apsteven/MSE-Control-Boards/Micro_RC_Receiver/Micro_RC_Receiver-master/2.jpg

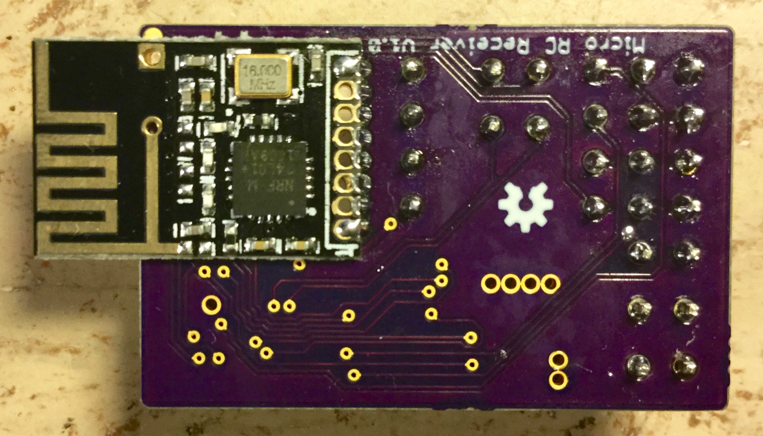
Micro_RC_Receiver/Micro_RC_Receiver-master/2.jpg
