apsteven/MSE-Control-Boards/Micro_RC_Receiver/Micro_RC_Receiver-master/1.jpg

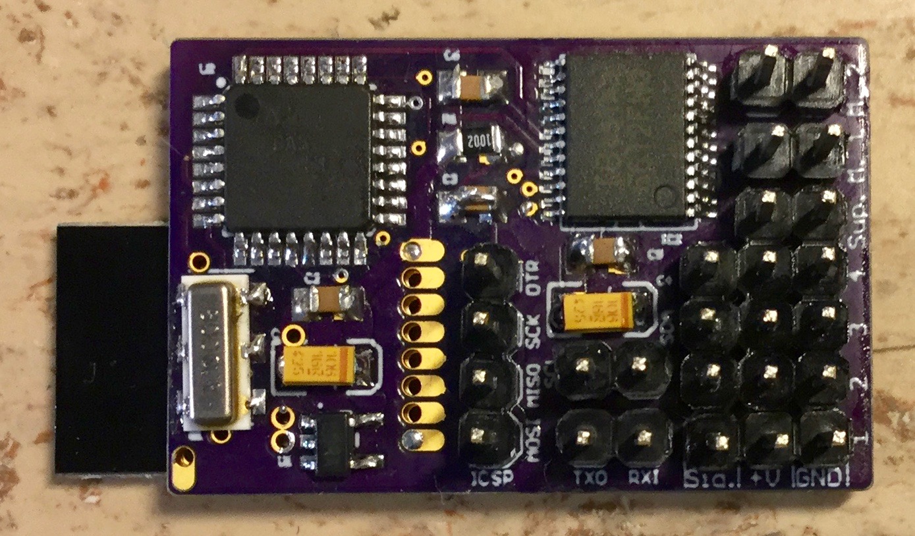
Micro_RC_Receiver/Micro_RC_Receiver-master/1.jpg
