apsteven/MSE-Control-Boards/Micro_RC_Receiver/Micro_RC_Receiver-master/3.jpg

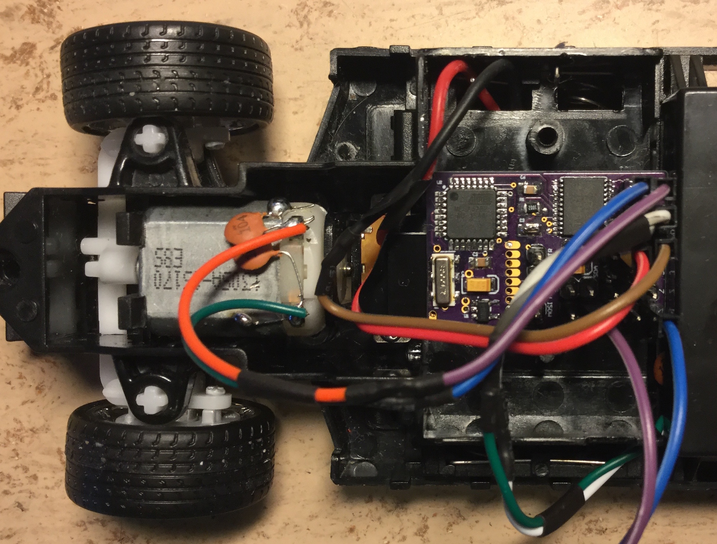
Micro_RC_Receiver/Micro_RC_Receiver-master/3.jpg
