apsteven/MSE-Control-Boards/Micro_RC_Receiver/Micro_RC_Receiver-master/Micro_RC_Receiver.png

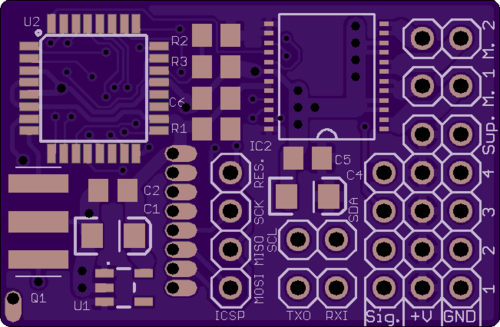
Micro_RC_Receiver/Micro_RC_Receiver-master/Micro_RC_Receiver.png
