apsteven/MSE-Control-Boards/Micro_RC_Receiver/Micro_RC_Receiver-master/MPU-6050_Shield.png

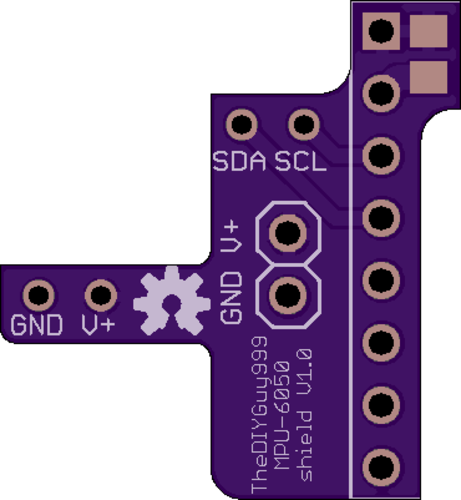
Micro_RC_Receiver/Micro_RC_Receiver-master/MPU-6050_Shield.png
