apsteven/MSE-Control-Boards/RC_Transmitter/1.jpg

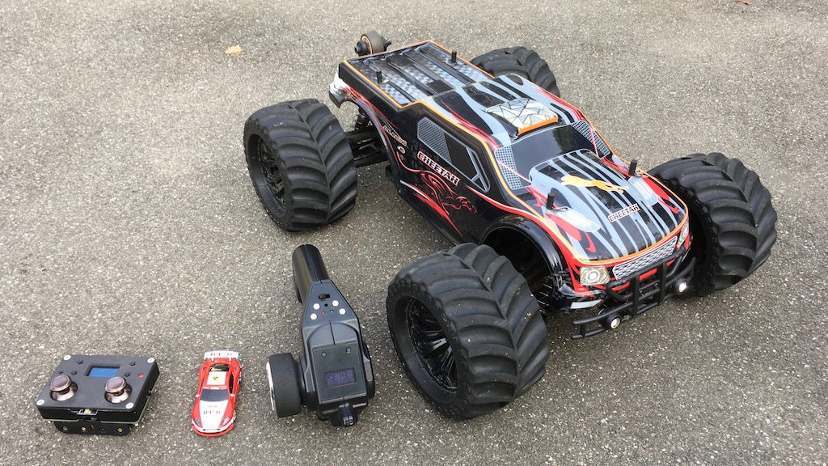
RC_Transmitter/1.jpg
