apsteven/MSE-Control-Boards/RC_Transmitter/Micro RC Transmitter.jpg

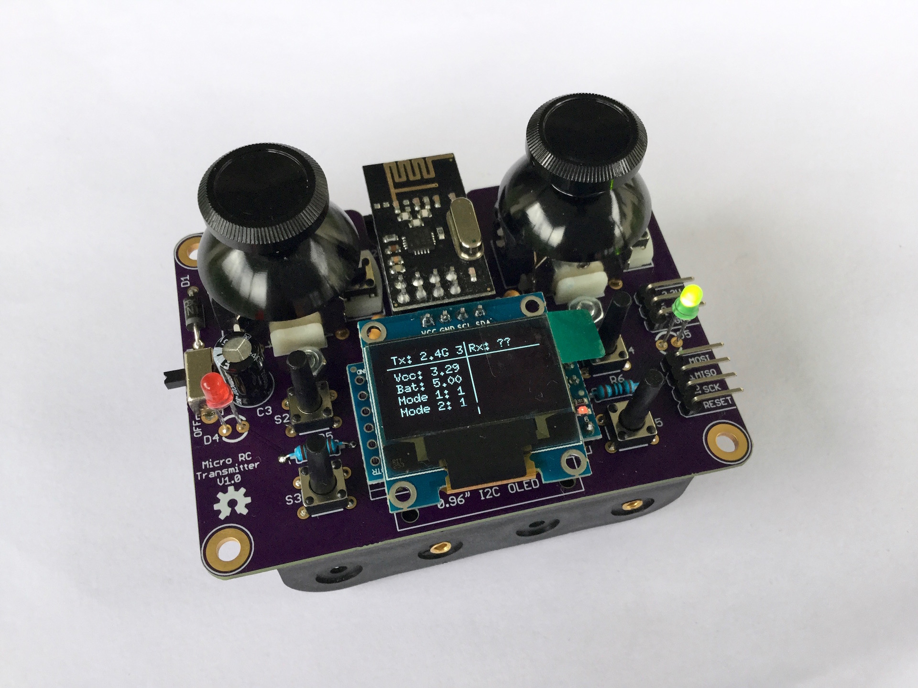
RC_Transmitter/Micro RC Transmitter.jpg
