apsteven/MSE-Control-Boards/RC_Transmitter/Micro_RC_Transmitter.jpg

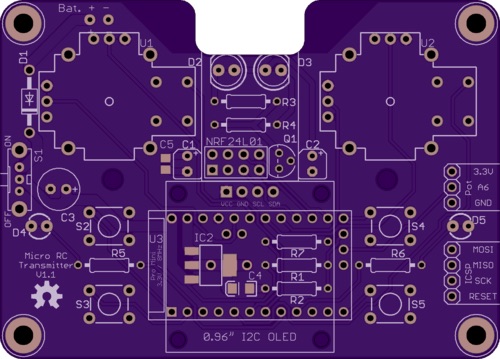
RC_Transmitter/Micro_RC_Transmitter.jpg
