apsteven/MSE-Control-Boards/Micro_RC_Receiver/Housing/Top Housing High Power.stl

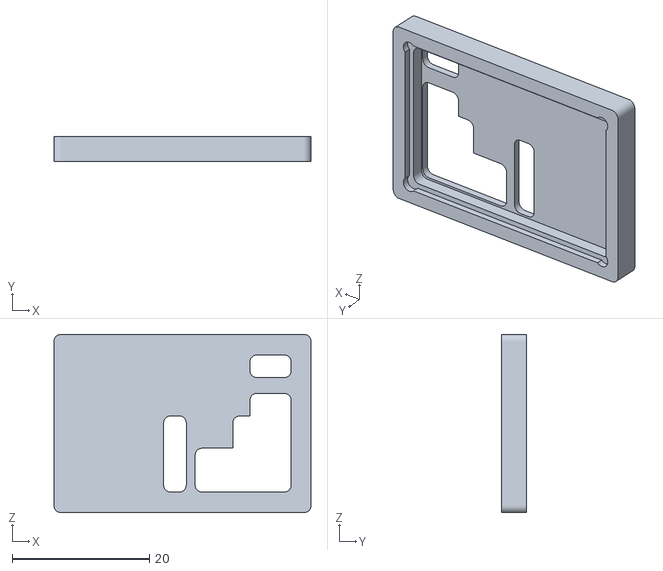
[picture p9: CAD file, 2019-11-13]
Micro_RC_Receiver/Housing/Top Housing High Power.stl
37.5 x 3.60 x 26.0
