apsteven/MSE-Control-Boards/RC_Transmitter/Housing/Transmitter Frame.stl

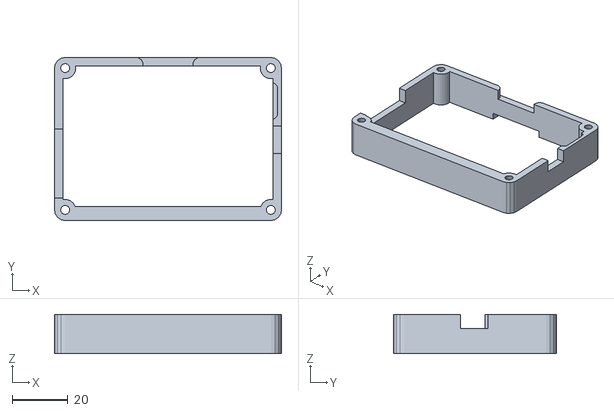
[picture p10: CAD file, 2019-11-13]
RC_Transmitter/Housing/Transmitter Frame.stl
81.3 x 58.4 x 14.0
