apsteven/MSE-Control-Boards/Micro_RC_Receiver/Housing/Top Housing Dual DC Motors.stl

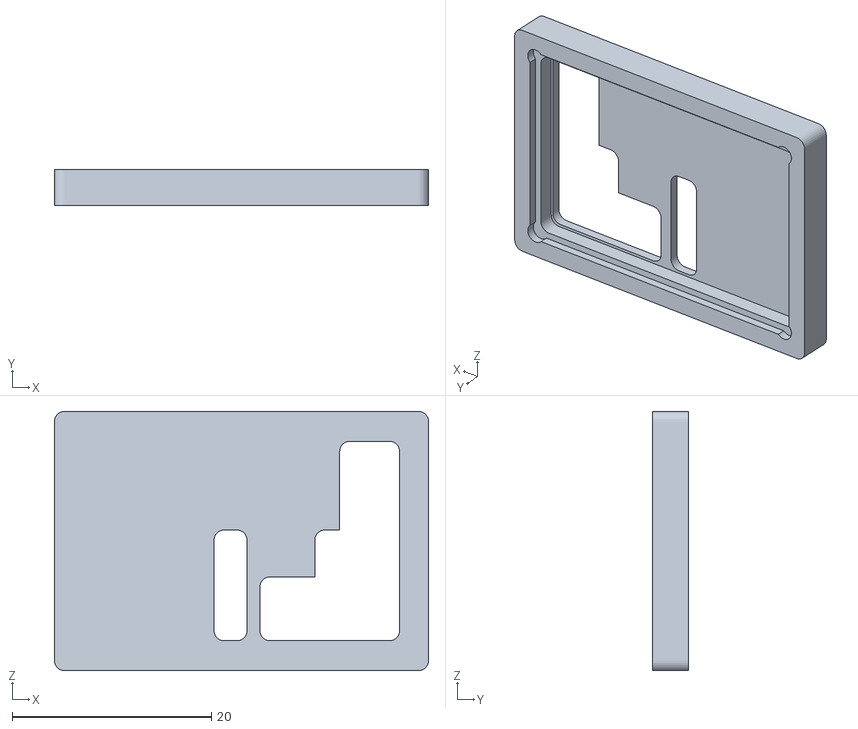
[picture p11: CAD file, 2019-11-13]
Micro_RC_Receiver/Housing/Top Housing Dual DC Motors.stl
37.5 x 3.60 x 26.0
