apsteven/MSE-Control-Boards/RC_Transmitter/Housing/Transmitter Cover.stl

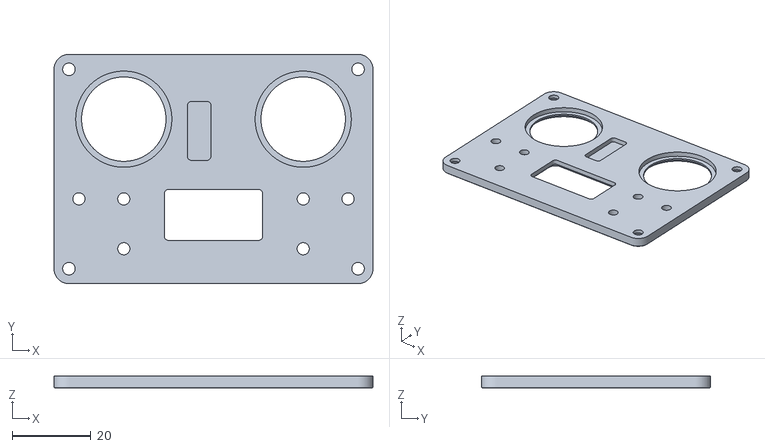
[picture p12: CAD file, 2019-11-13]
RC_Transmitter/Housing/Transmitter Cover.stl
81.3 x 58.4 x 3.00
