apsteven/MSE-Control-Boards/Micro_RC_Receiver/Housing/Bottom Housing.stl

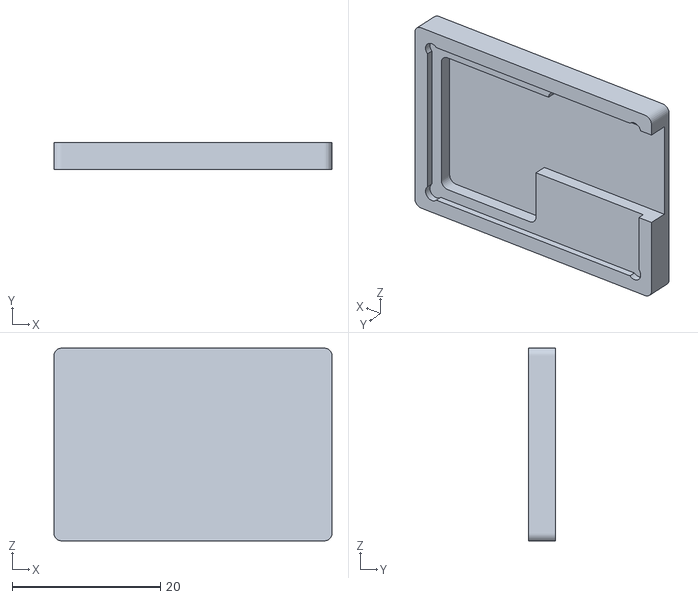
[picture p13: CAD file, 2019-11-13]
Micro_RC_Receiver/Housing/Bottom Housing.stl
37.5 x 3.60 x 26.0
