apsteven/MSE-Control-Boards/Micro_RC_Receiver/Housing/Pin Header Cover 3x.stl

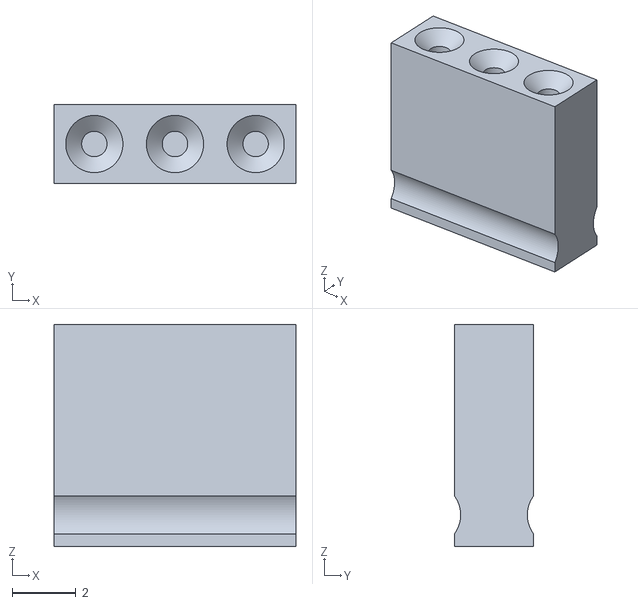
[picture p14: CAD file, 2019-11-13]
Micro_RC_Receiver/Housing/Pin Header Cover 3x.stl
7.62 x 2.50 x 7.00
