apsteven/MSE-Control-Boards/Micro_RC_Receiver/Housing/Pin Header Cover 4x.stl

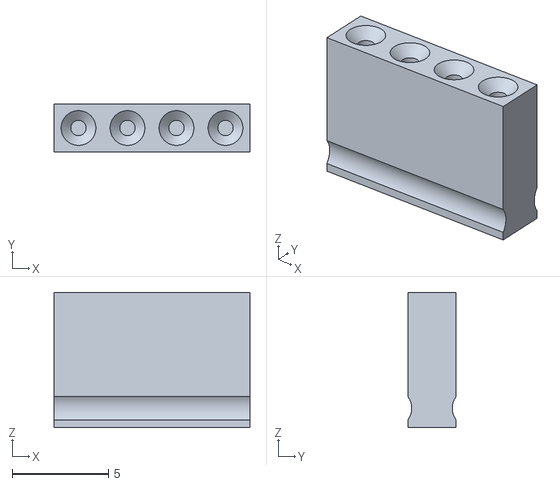
[picture p15: CAD file, 2019-11-13]
Micro_RC_Receiver/Housing/Pin Header Cover 4x.stl
10.2 x 2.50 x 7.00
