apsteven/MSE-Control-Boards/Micro_RC_Receiver/Housing/Pin Header Cover 2x.stl

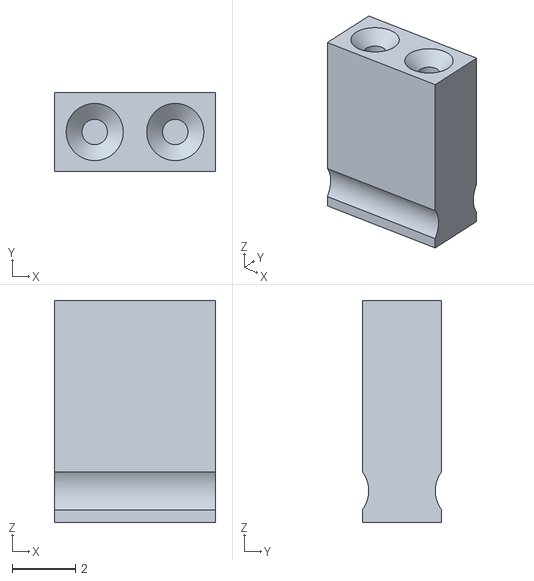
[picture p16: CAD file, 2019-11-13]
Micro_RC_Receiver/Housing/Pin Header Cover 2x.stl
5.08 x 2.50 x 7.00
