apsteven/MSE-Control-Boards/(list of files, cad)

Other CAD files:
Micro_RC_Receiver/Housing/Top Housing No DC Motor.stl
