apsteven/MSE-Control-Boards/Micro_RC_Receiver/MPU-6050_Shield/MPU-6050 Shield.brd

## EAGLE design Micro_RC_Receiver/MPU-6050_Shield/MPU-6050 Shield.brd (2019-11-13)

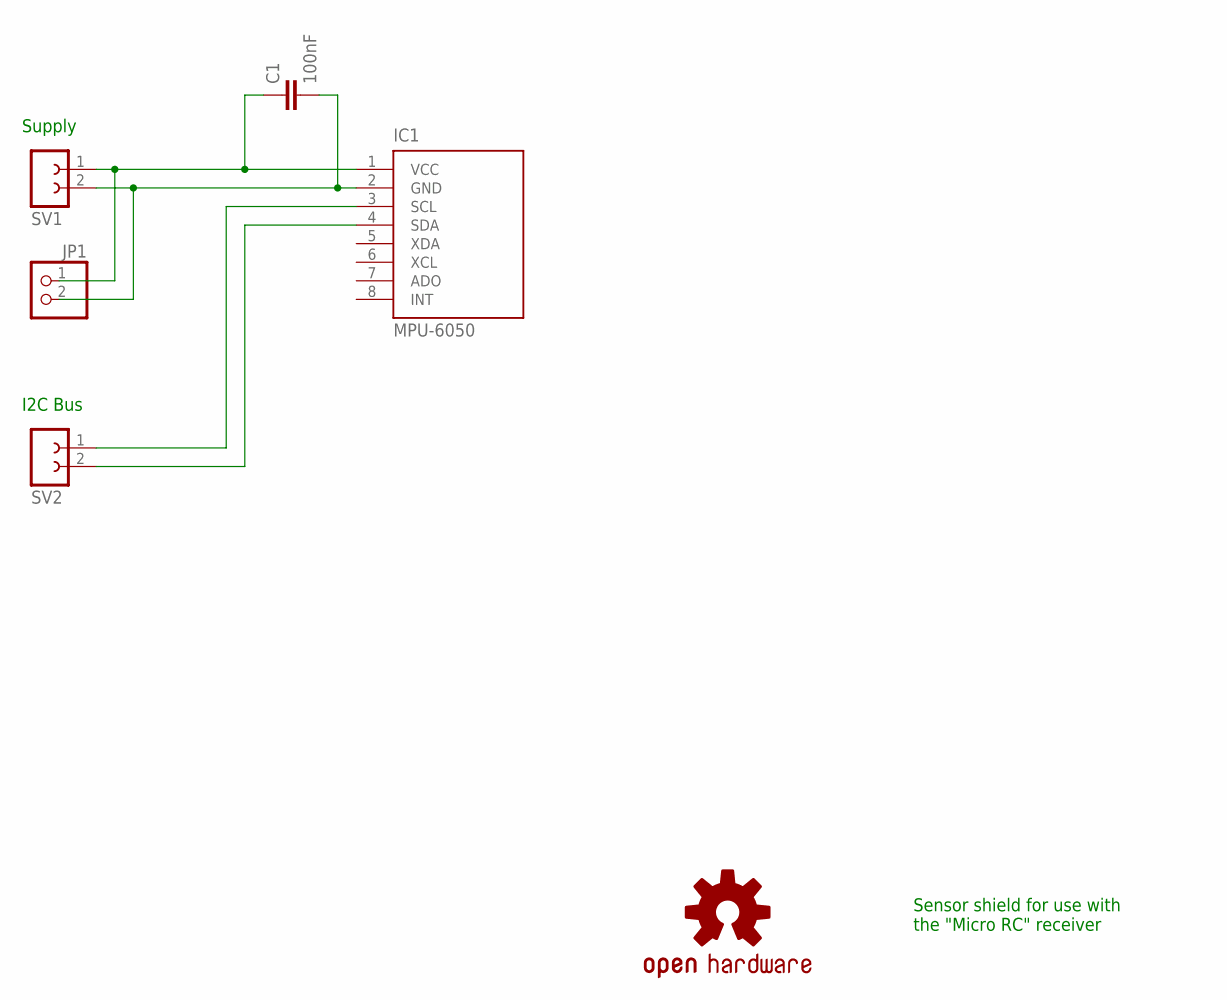
[picture p17: schematic MPU-6050 Shield.sch]

Parts:
C1: 100nF; C0805
IC1: MPU-6050; MPU-6050_GY521
JP1: PINHD-1X2; 1X02
LOGO1: OSHW-LOGOS; OSHW-LOGO-S
SV1, SV2: FE02-1

Connections:
GND: C1.2, IC1.2 (GND), JP1.2, SV1.2
unnamed: IC1.3 (SCL), SV2.1
unnamed: IC1.4 (SDA), SV2.2
VCC: C1.1, IC1.1 (VCC), JP1.1, SV1.1

Notes on the sheet:
Supply
I2C Bus
Sensor shield for use with the "Micro RC" receiver

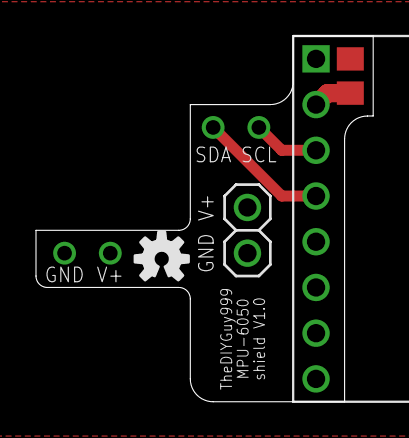
[picture p18: board MPU-6050 Shield.brd from above]

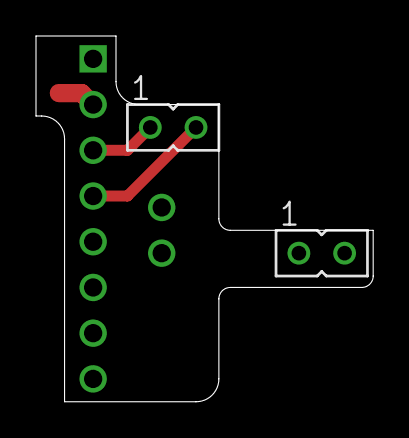
[picture p19: board MPU-6050 Shield.brd from below]

Board: 2 copper layers, 18.7 x 20.3 mm, 6 parts (2 on the bottom side), 4 nets.
