apsteven/MSE-Control-Boards/RC_Transmitter/Micro RC Transmitter.brd

## EAGLE design RC_Transmitter/Micro RC Transmitter.brd (2019-11-13)

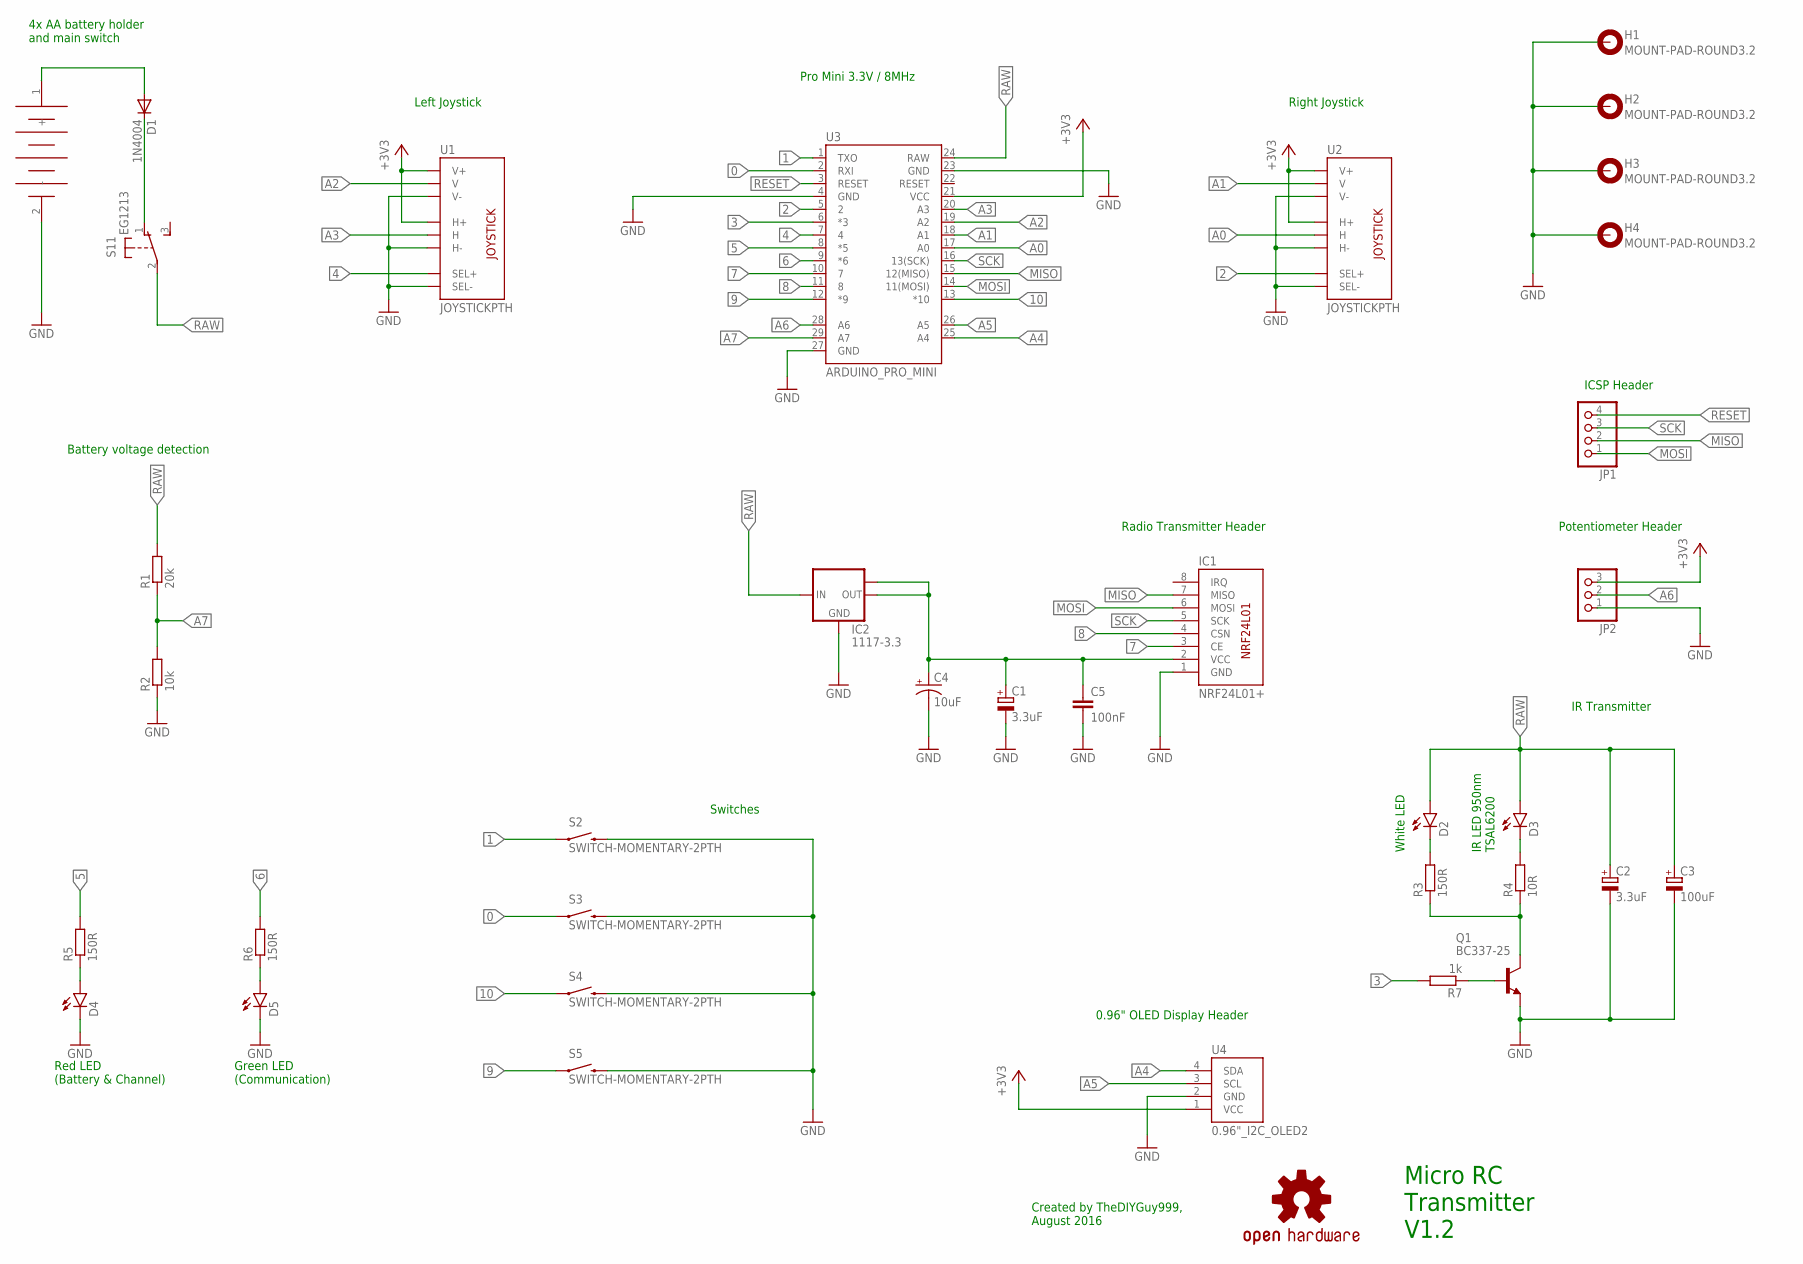
[picture p20: schematic Micro RC Transmitter.sch]

Parts:
C1, C2: 3.3uF; B45181A
C3: 100uF; E2,5-7
C4: 10uF; EIA3216
C5: 100nF; C0805
D1: 1N4004; DO41-10
D2, D3: LED5MM
D4, D5: LED3MM
G1: 4X_AA_BATTERY_HOLDER
H1, H2, H3, H4: MOUNT-PAD-ROUND3.2; 3,2-PAD
IC1: NRF24L01+; NRF24L01
IC2: 1117-3.3; SOT223
JP1: PINHD-1X4; 1X04
JP2: PINHD-1X3; 1X03
LOGO1: OSHW-LOGOM; OSHW-LOGO-M
Q1: BC337-25; TO92
R1: 20k; 0207/10
R2: 10k; 0207/10
R3, R5, R6: 150R; 0207/10
R4: 10R; 0207/10
R7: 1k; 0207/10
S1: EG1213
S2, S3, S4, S5: SWITCH-MOMENTARY-2PTH; TACTILE-PTH
U1, U2: JOYSTICKPTH; JOYSTICK
U3: ARDUINO_PRO_MINI
U4: 0.96"_I2C_OLED2; 0.96"_I2C_OLED_2

Connections:
0: S3.1, U3.2 (RXI)
1: S2.1, U3.1 (TXO)
2: U2.B1A (SEL+), U3.5 (2)
3: R7.2, U3.6 (*3)
4: U1.B1A (SEL+), U3.7 (4)
5: R5.2, U3.8 (*5)
6: R6.2, U3.9 (*6)
7: IC1.3 (CE), U3.10 (7)
8: IC1.4 (CSN), U3.11 (8)
9: S5.1, U3.12 (*9)
10: S4.1, U3.13 (*10)
+3V3: JP2.3, U1.H1 (H+), U1.V1 (V+), U2.H1 (H+), U2.V1 (V+), U3.21 (VCC), U4.1 (VCC)
A0: U2.H2 (H), U3.17 (A0)
A1: U2.V2 (V), U3.18 (A1)
A2: U1.V2 (V), U3.19 (A2)
A3: U1.H2 (H), U3.20 (A3)
A4: U3.25 (A4), U4.4 (SDA)
A5: U3.26 (A5), U4.3 (SCL)
A6: JP2.2, U3.28 (A6)
A7: R1.1, R2.2, U3.29 (A7)
GND: C1.-, C2.-, C3.-, C4.C (-), C5.2, D4.K (C), D5.K (C), G1.2 (-), H1.B3,2, H2.B3,2, H3.B3,2, H4.B3,2, IC1.1 (GND), IC2.1 (GND), JP2.1, Q1.1 (E), R2.1, S2.3 (2), S3.3 (2), S4.3 (2), S5.3 (2), U1.B2A (SEL-), U1.H3 (H-), U1.V3 (V-), U2.B2A (SEL-), U2.H3 (H-), U2.V3 (V-), U3.4 (GND), U3.23 (GND), U3.27 (GND), U4.2 (GND)
MISO: IC1.7 (MISO), JP1.2, U3.15 (12(MISO))
MOSI: IC1.6 (MOSI), JP1.1, U3.14 (11(MOSI))
unnamed: D4.A, R5.1
unnamed: D5.A, R6.1
unnamed: Q1.3 (C), R3.1, R4.1
unnamed: D3.K (C), R4.2
unnamed: Q1.2 (B), R7.1
unnamed: D2.K (C), R3.2
unnamed: D1.A, G1.1 (+)
unnamed: D1.C, S1.1 (O)
unnamed: C1.+, C4.A (+), C5.1, IC1.2 (VCC), IC2.2 (OUT), IC2.TAB (OUT1)
RAW: C2.+, C3.+, D2.A, D3.A, IC2.3 (IN), R1.2, S1.2, U3.24 (RAW)
RESET: JP1.4, U3.3 (RESET)
SCK: IC1.5 (SCK), JP1.3, U3.16 (13(SCK))

Notes on the sheet:
Red LED (Battery & Channel)
Green LED (Communication)
Micro RC Transmitter V1.2
White LED
IR LED 950nm TSAL6200
IR Transmitter
Radio Transmitter Header
4x AA battery holder and main switch
Left Joystick
Right Joystick
0.96" OLED Display Header
Battery voltage detection
Switches
ICSP Header
Pro Mini 3.3V / 8MHz
Potentiometer Header
Created by TheDIYGuy999, August 2016

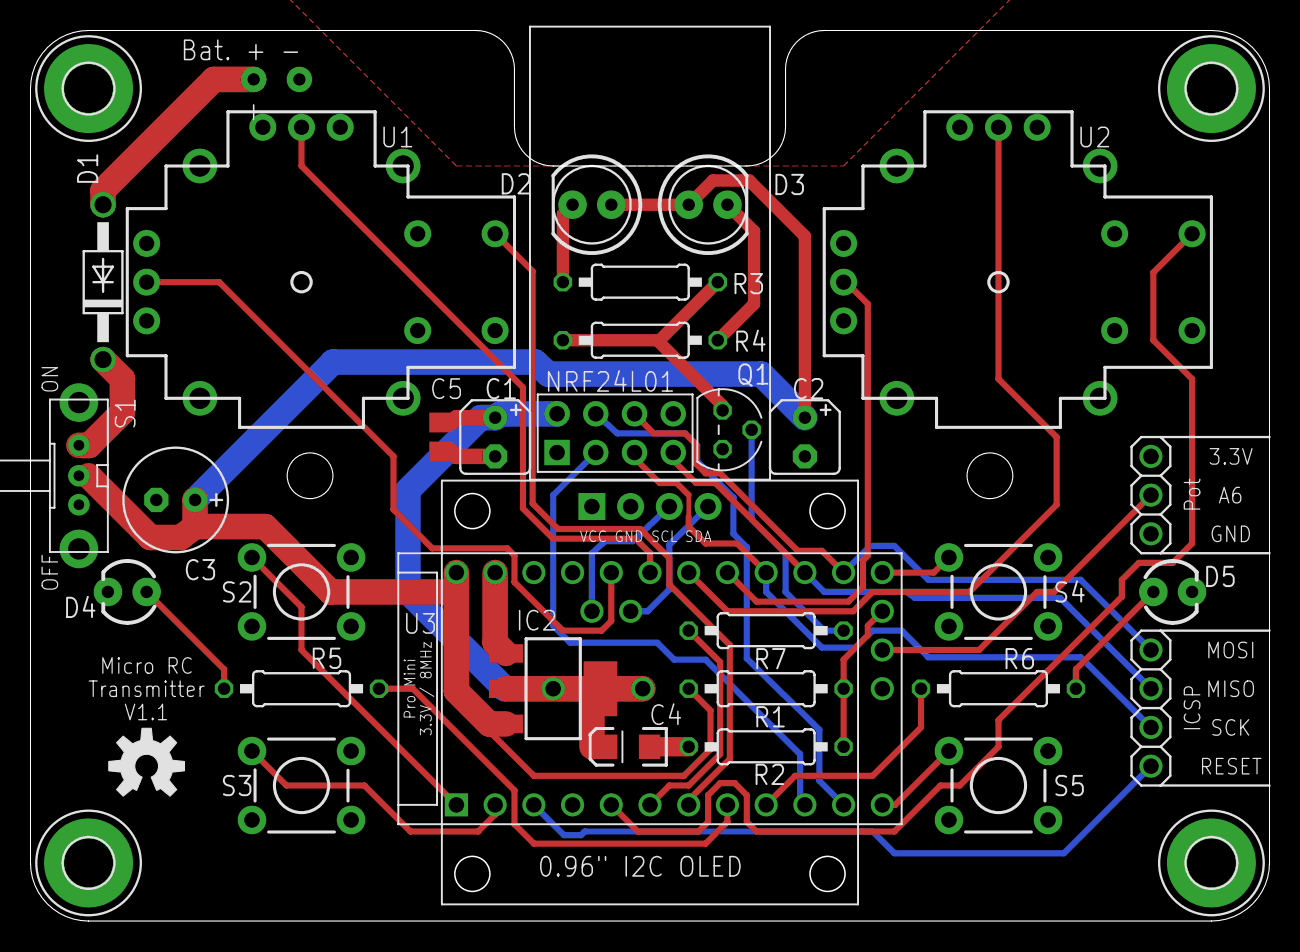
[picture p21: board Micro RC Transmitter.brd from above]

Board: 2 copper layers, 81.3 x 58.4 mm, 37 parts (1 on the bottom side), 35 nets.
