apsteven/MSE-Control-Boards/Micro_RC_Receiver/Micro_RC_Receiver-master/Micro_RC_Receiver/helper.h

#ifndef helper_h
#define helper_h

#include "Arduino.h"

//
// =======================================================================================================
// LOOP TIME MEASUREMENT
// =======================================================================================================
//

unsigned int loopTime;

void loopDuration() {
  static unsigned long timerOld;
  unsigned long timer = millis();
  loopTime = timer - timerOld;
  timerOld = timer;
}

#endif
